SK21/YieldFlo/PCBs/Moisture1/Moisture1.png

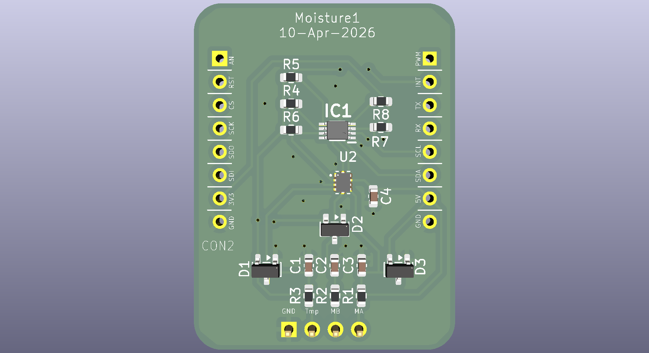
PCBs/Moisture1/Moisture1.png
