SK21/YieldFlo/PCBs/YF1/YF1.png

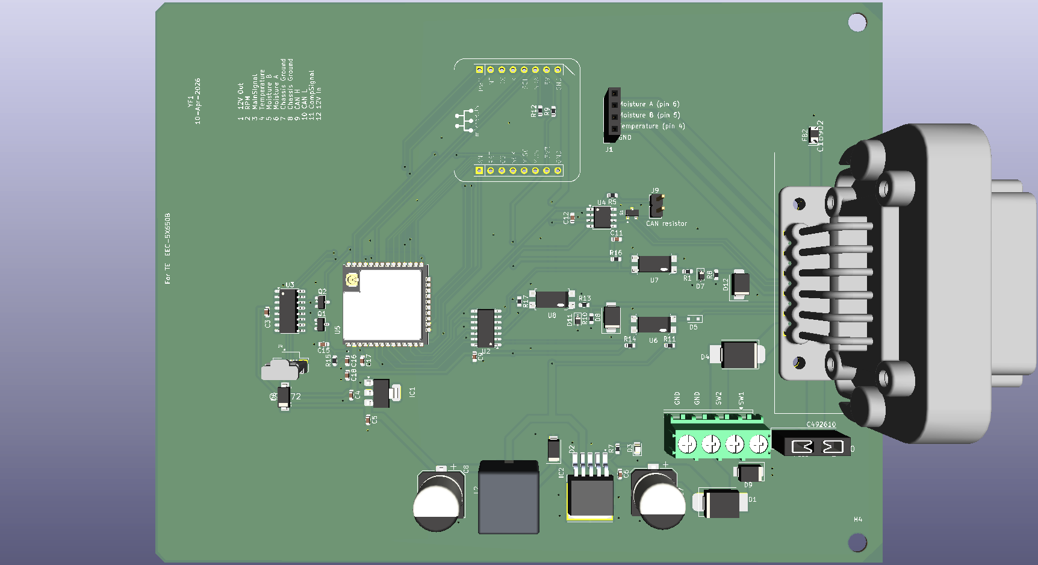
PCBs/YF1/YF1.png
