SK21/YieldFlo/PCBs/Moisture1/jlcpcb/production_files/BOM-Moisture1.csv

Comment | Designator | Footprint | LCSC | Quantity
0.1uF | C4 | C_0603_1608Metric | C14663 | 1
10nf | C1,C2,C3 | C_0603_1608Metric | C389113 | 3
1K | R1,R2,R3 | R_0603_1608Metric | C21190 | 3
200K | R6 | R_0603_1608Metric | C25811 | 1
217 | R7,R8 | R_0603_1608Metric | C2930075 | 2
341 | R4,R5 | R_0603_1608Metric | C23138 | 2
ADS1115IRUGR | U2 | IC_ADS1115IRUGR | C2651328 | 1
BAV99 | D1,D2,D3 | SOT-23 | C2500 | 3
PCA9306DCUR | IC1 | PCA9306DCUR | C33196 | 1
MIKROBUS_MODULE_CONN | CON2 | MIKROBUS_MODULE_CONN |  | 1
Conn_01x04_Pin | J1 | PinHeader_1x04_P2.54mm_Vertical |  | 1
