SK21/YieldFlo/InnoMaker_Setup.txt

YieldFlo — InnoMaker USB2CAN setup
==================================

The next YieldFlo build adds support for the InnoMaker USB2CAN adapter.
To use it:

1. Install InnoMaker's Windows driver for the USB2CAN adapter
   (from the InnoMaker website or their driver installer).

2. Download the InnoMaker USB2CAN C# SDK and copy these two files
   into the YieldFlo application folder (the folder containing
   YieldFlo.exe):

       InnoMakerUsb2CanLib.dll
       LibUsbDotNet.dll

   These are the only DLLs in the C# SDK's Lib folder — InnoMaker
   ships them 32-bit only. Download them as raw files (from the GitHub
   page use the Download button on each file, or download the whole
   repo as a zip — saving the web page itself gives a corrupt DLL).

   If the error log said "bitness does not match" or "class
   InnoMakerUsb2CanLib not found", update YieldFlo.exe to the newest
   build (2026-07-06 or later) — the DLLs are fine, keep them where
   they are.

PCAN (alternative adapter)
--------------------------
   YieldFlo builds BEFORE 2026-07-06 did not support PCAN at all (the
   driver was an empty stub) — update YieldFlo.exe first. Then: install
   the PEAK device driver package from peak-system.com (it includes
   PCAN-Basic), select CAN Driver: PCAN in YieldFlo, Save & Apply,
   restart. Nothing needs to be copied into the app folder.

Checking whether the module is sending (any adapter)
----------------------------------------------------
   The module sends unsolicited; the PC only listens. But CAN frames
   need at least one ACTIVE receiver on the bus — if no program has the
   adapter open, the module's frames are not acknowledged and (on the
   STM32 module, which sends single-shot) simply vanish. "No messages
   on the bus" therefore usually means the PC side never opened, not
   that the module is silent.

   To test the module independent of YieldFlo: open PCAN-View (PEAK's
   free tool) at 250 kbit/s in normal mode (NOT listen-only). A working
   module shows ID 18FF00F8h at 5 Hz and 18FF01F8h at 1 Hz.

3. In YieldFlo:  Menu > Settings > Module communication
   - select CAN
   - CAN Driver: InnoMaker
   - COM Port is ignored for InnoMaker (the first adapter found is
     used), then Save & Apply and restart when prompted.

If CAN still fails to start, send the newest file from:

       Documents\YieldFlo\Logs

The exact reason (DLL missing, wrong bitness, no adapter found, etc.)
is written there.

STM32F1 module checklist (module side)
--------------------------------------
- The sketch must be compiled with USB support set to "None"
  (Arduino IDE > Tools > USB support). USB and CAN share memory on
  the F103 — with USB enabled, CAN silently does not work.
- Debug output is on USART1 (PA9/PA10) at 38400 baud; at power-up it
  should print "CAN started at 250kbps."
- CAN wiring: PB9 = TX, PB8 = RX to the transceiver; bus needs 120 ohm
  termination at both ends.
