SK21/YieldFlo/YieldFlo/Help/YieldFlo User Manual.html

# YieldFlo User Manual

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

## Table of Contents

1. Getting Started
2. Main Screen
3. Jobs
4. Crops
5. Headers
6. Profiles
7. Fields
8. Yield Calibration
9. Moisture Calibration
10. Yield Map
11. Job Report
12. Settings
13. Language
14. Module Web Portal
15. Troubleshooting

↑ Contents

## 1. Getting Started

### Requirements

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

No installer is required. Extract the YieldFlo folder to any location and run YieldFlo.exe.

### Hardware module

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

### Network

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

### Recommended first-run setup

On first launch YieldFlo creates a default crop, header, and profile. Before starting your first job:

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

↑ Contents

## 2. Main Screen

The main screen displays live harvest data and job status.

### Toolbar buttons

Left to right, as they appear on screen:

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

### Data panels

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

### Sensor bars

Two horizontal bar gauges below the data panels:

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

### Status bar

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

### Compact (mini) view

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

↑ Contents

## 3. Jobs

Menu: Menu → Jobs

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

### Starting a job

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

### Managing jobs

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

Only one job can be active at a time.

### Auto-pause

The job automatically pauses when harvesting stops:

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

### Manual pause and resume

Press Pause on the main screen to manually pause recording. Press Start to resume.

### Stopping a job

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

### Resume on start

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

↑ Contents

## 4. Crops

Menu: Menu → Crops

Crops store the grain-specific parameters used in yield calculations and reporting.

### Crop settings

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

### Adding a crop

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

↑ Contents

## 5. Headers

Menu: Menu → Headers

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

### Header settings

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

### Adding a header

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

↑ Contents

## 6. Profiles

Menu: Menu → Profiles

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

### Profile settings

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

### Adding a profile

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

At least one profile must exist at all times.

↑ Contents

## 7. Fields

Menu: Menu → Fields

Fields are optional location labels that can be assigned to jobs for organisation and reporting.

### Adding a field

1. Press New and enter a field name
2. Press Save

Fields are not required. A job can be created without a field selected.

### Importing fields from AgOpenGPS

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

↑ Contents

## 8. Yield Calibration

Menu: Menu → Yield Cal

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

### Setting the baseline

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

### Noise readout

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

### Paddle rate readout

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

### Processing delay

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

### Running a calibration pass

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

### Manual factor adjustment

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

↑ Contents

## 9. Moisture Calibration

Menu: Menu → Moisture Cal

Moisture and temperature readings are both calculated the same way:

Value = raw_count × scale  +  offset

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

scale = known_value / raw_count

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

### Moisture calibration procedure

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

### Moisture calibration fields

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

### Temperature calibration

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

Note: Temperature calibration is optional. Temperature does not appear directly on the main screen.

↑ Contents

## 10. Yield Map

Menu: Menu → Yield Map

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

### Colour scale

Yield is mapped to a five-colour gradient:

Colour | Yield
Blue | Lowest
Cyan | Low
Green | Mid
Yellow | High
Red | Highest

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

### Mini mode

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

The mini map position is remembered between sessions.

### Full-screen mode

Click the map or press × to expand to full screen. The toolbar at the top provides:

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

The map can be dragged in both mini and full-screen modes.

### Live update during harvest

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

### Recalculating yield

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

### Exporting the map as a PNG

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

The export folder is remembered for subsequent exports.

↑ Contents

## 11. Job Report

Menu: Menu → Reports

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

### Report contents

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

### Printing a report

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

### CSV export

Press Export CSV to save all raw data points for the selected job.

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

↑ Contents

## 12. Settings

Menu: Menu → Settings

### Units

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

### Module communication

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

#### Supported CAN adapters

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

### Resume Job on Start

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

### Saving settings

Press Save & Apply to save and apply all settings immediately.

↑ Contents

## 13. Language

Menu: Menu → Language

YieldFlo supports the following languages:

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

### Changing language

1. Press Menu → Language
2. Select the desired language from the list
3. Press Save & Restart

YieldFlo will restart automatically with the new language applied.

Note: If AgOpenGPS is already installed, YieldFlo will automatically use the same language on first launch.

↑ Contents

## 14. Module Web Portal

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

### Opening the portal

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

### Settings

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

Press Save / Restart to store the settings in the module and restart it.

### Firmware update

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

↑ Contents

## 15. Troubleshooting

### GPS indicator stays red

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

### Module indicator stays off

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

### Yield reads zero or very low

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

### Moisture reads incorrectly

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

### App crashes on start

- Check YieldFlo_Crash.log in the application folder for details

### Job does not resume after restart

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

### AOG UDP failed to start

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

↑ Contents

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
