SK21/YieldFlo/PCBs/Moisture1/Moisture1.pdf

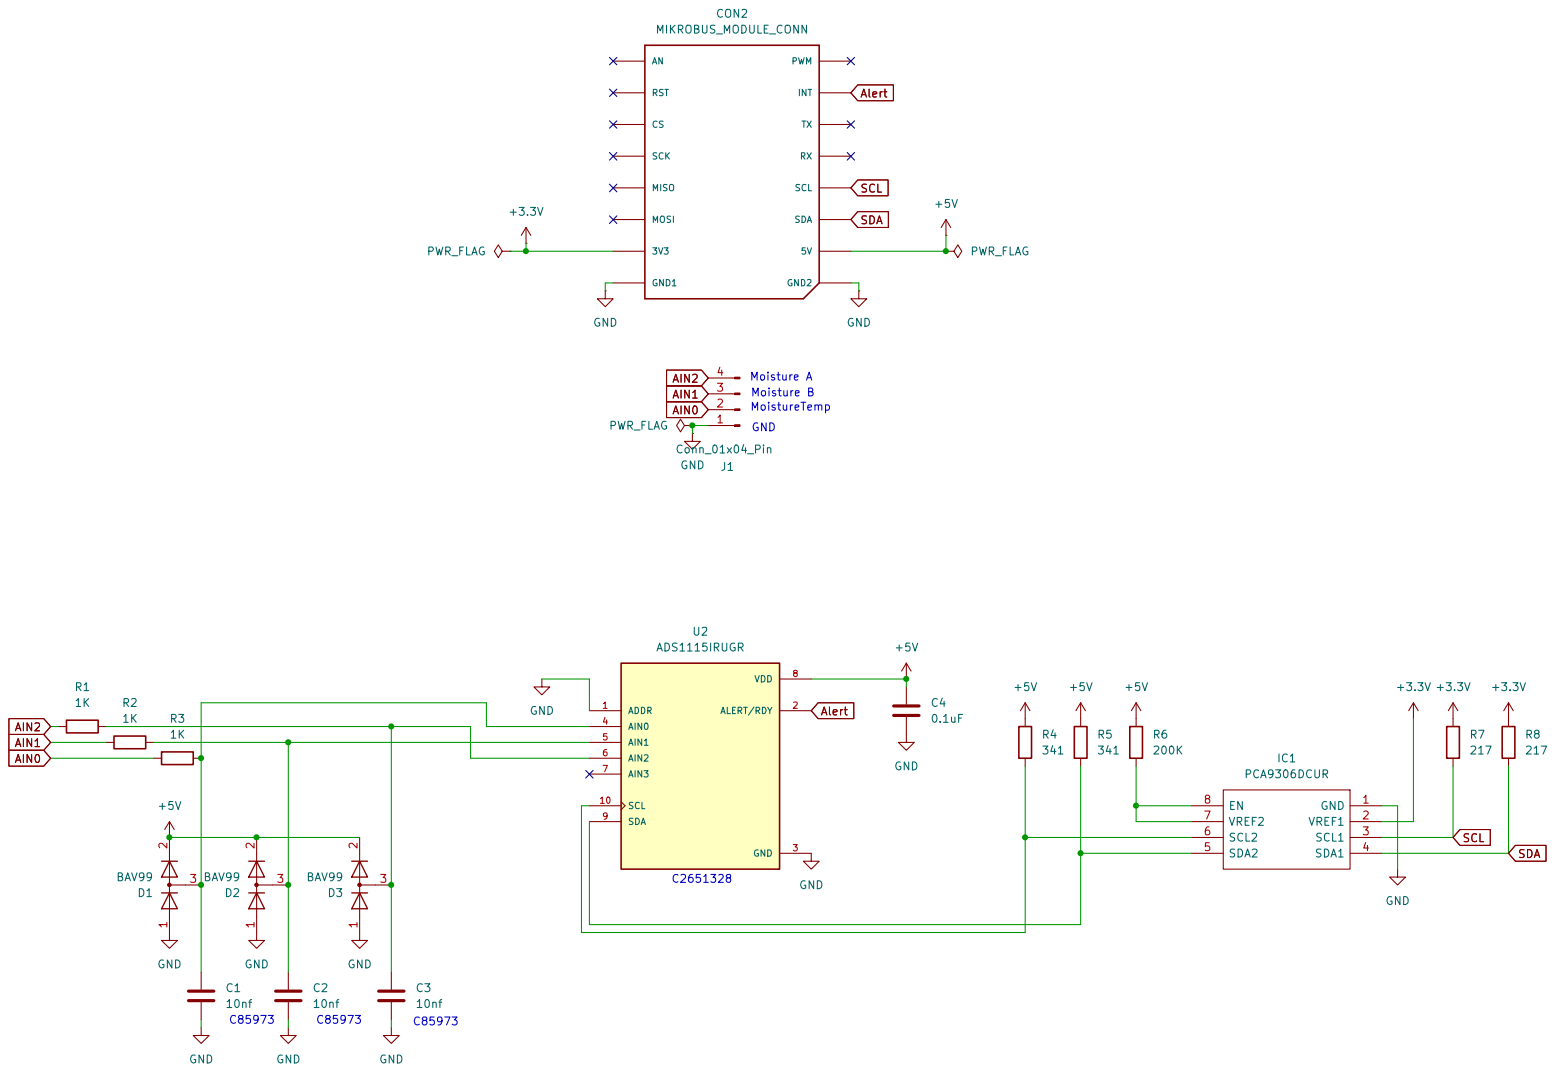
[picture p4: page 1]
