SK21/YieldFlo/PCBs/YF1/YF1.pdf

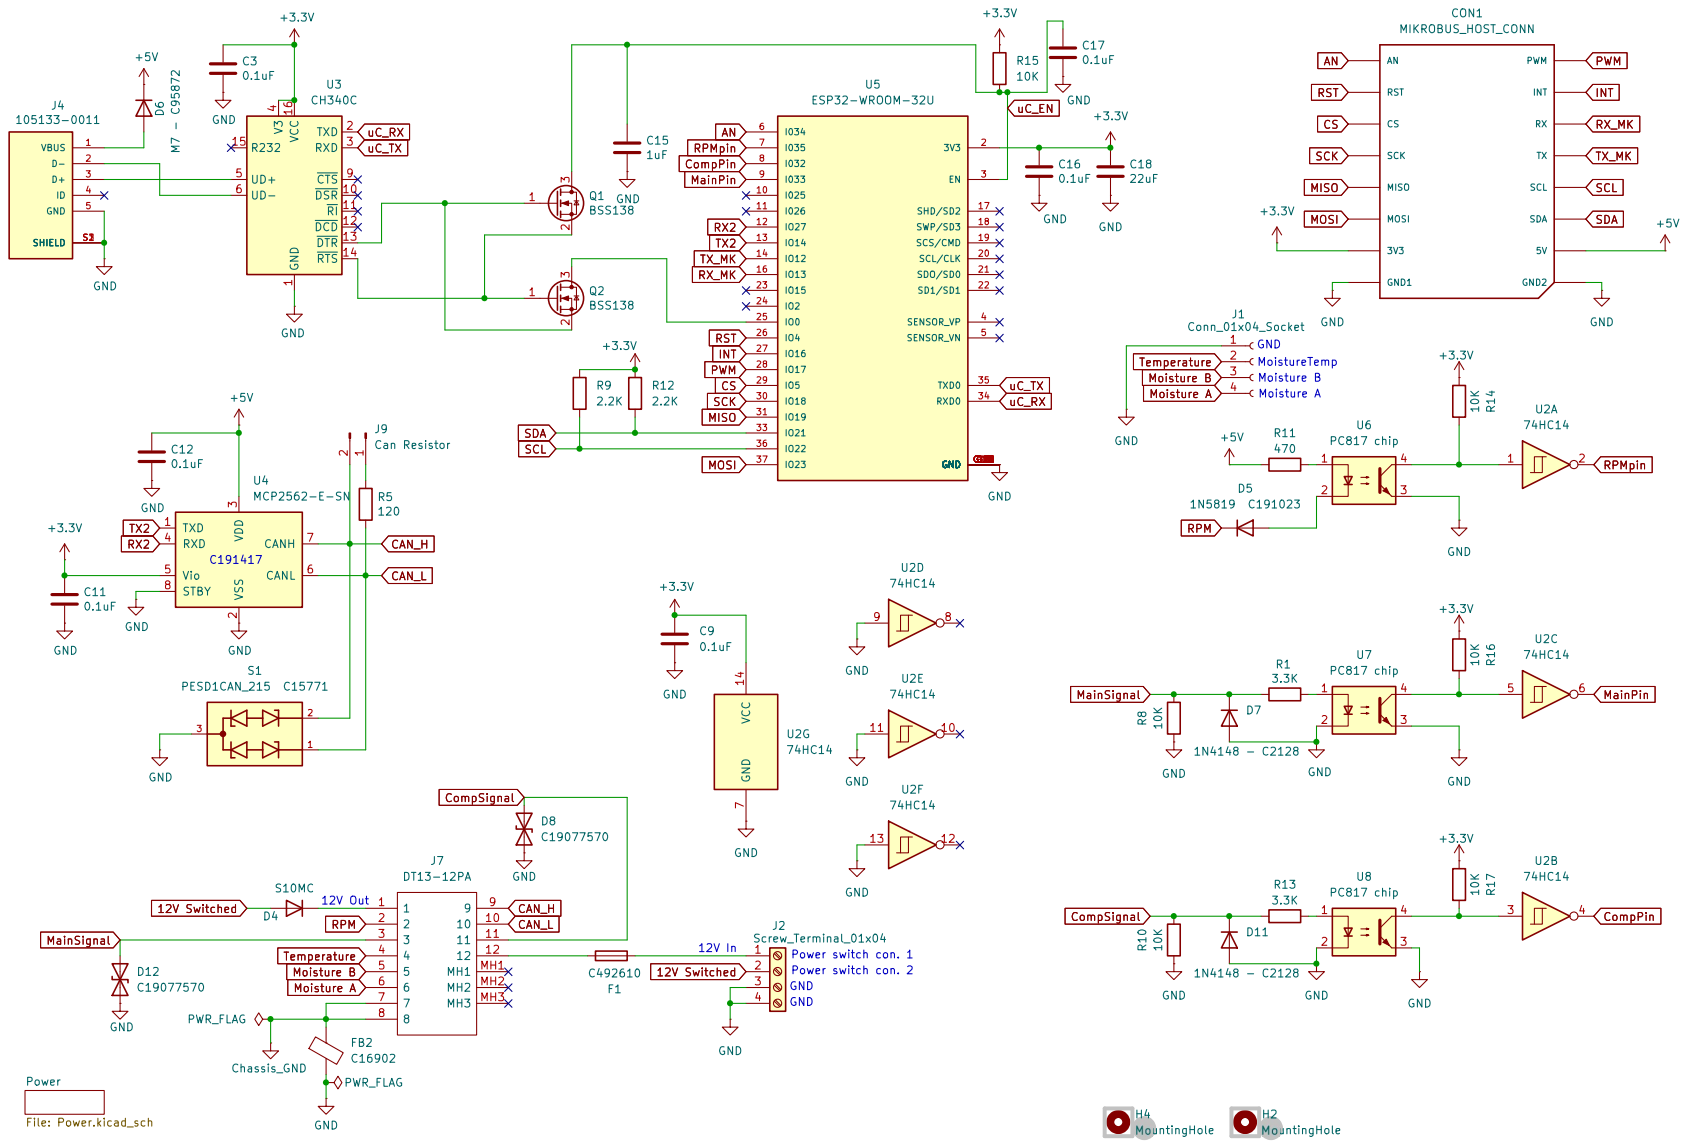
[picture p5: page 1]

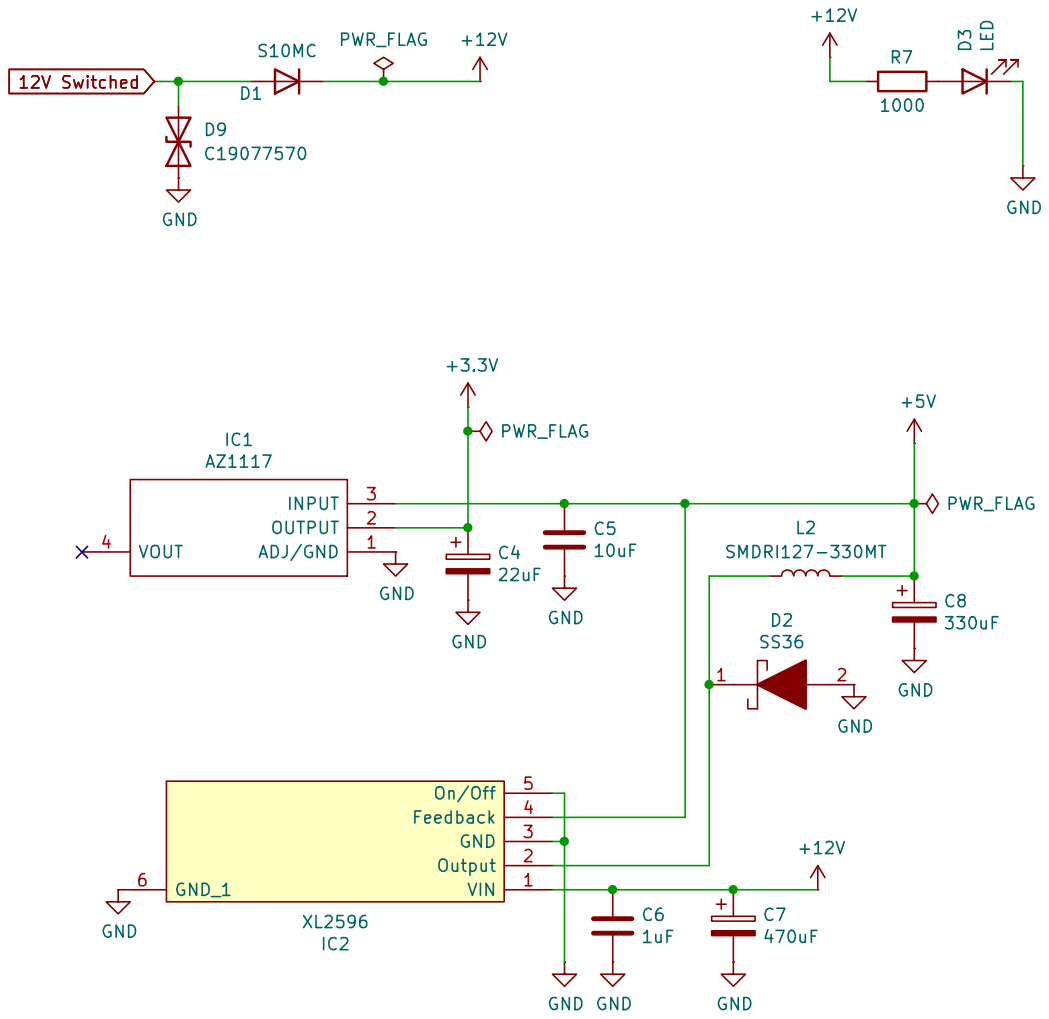
[picture p6: page 2]
