SK21/YieldFlo/PCBs/YF1/YF1.kicad_pcb

## KiCad design PCBs/YF1/YF1.kicad_pcb (2026-07-23)

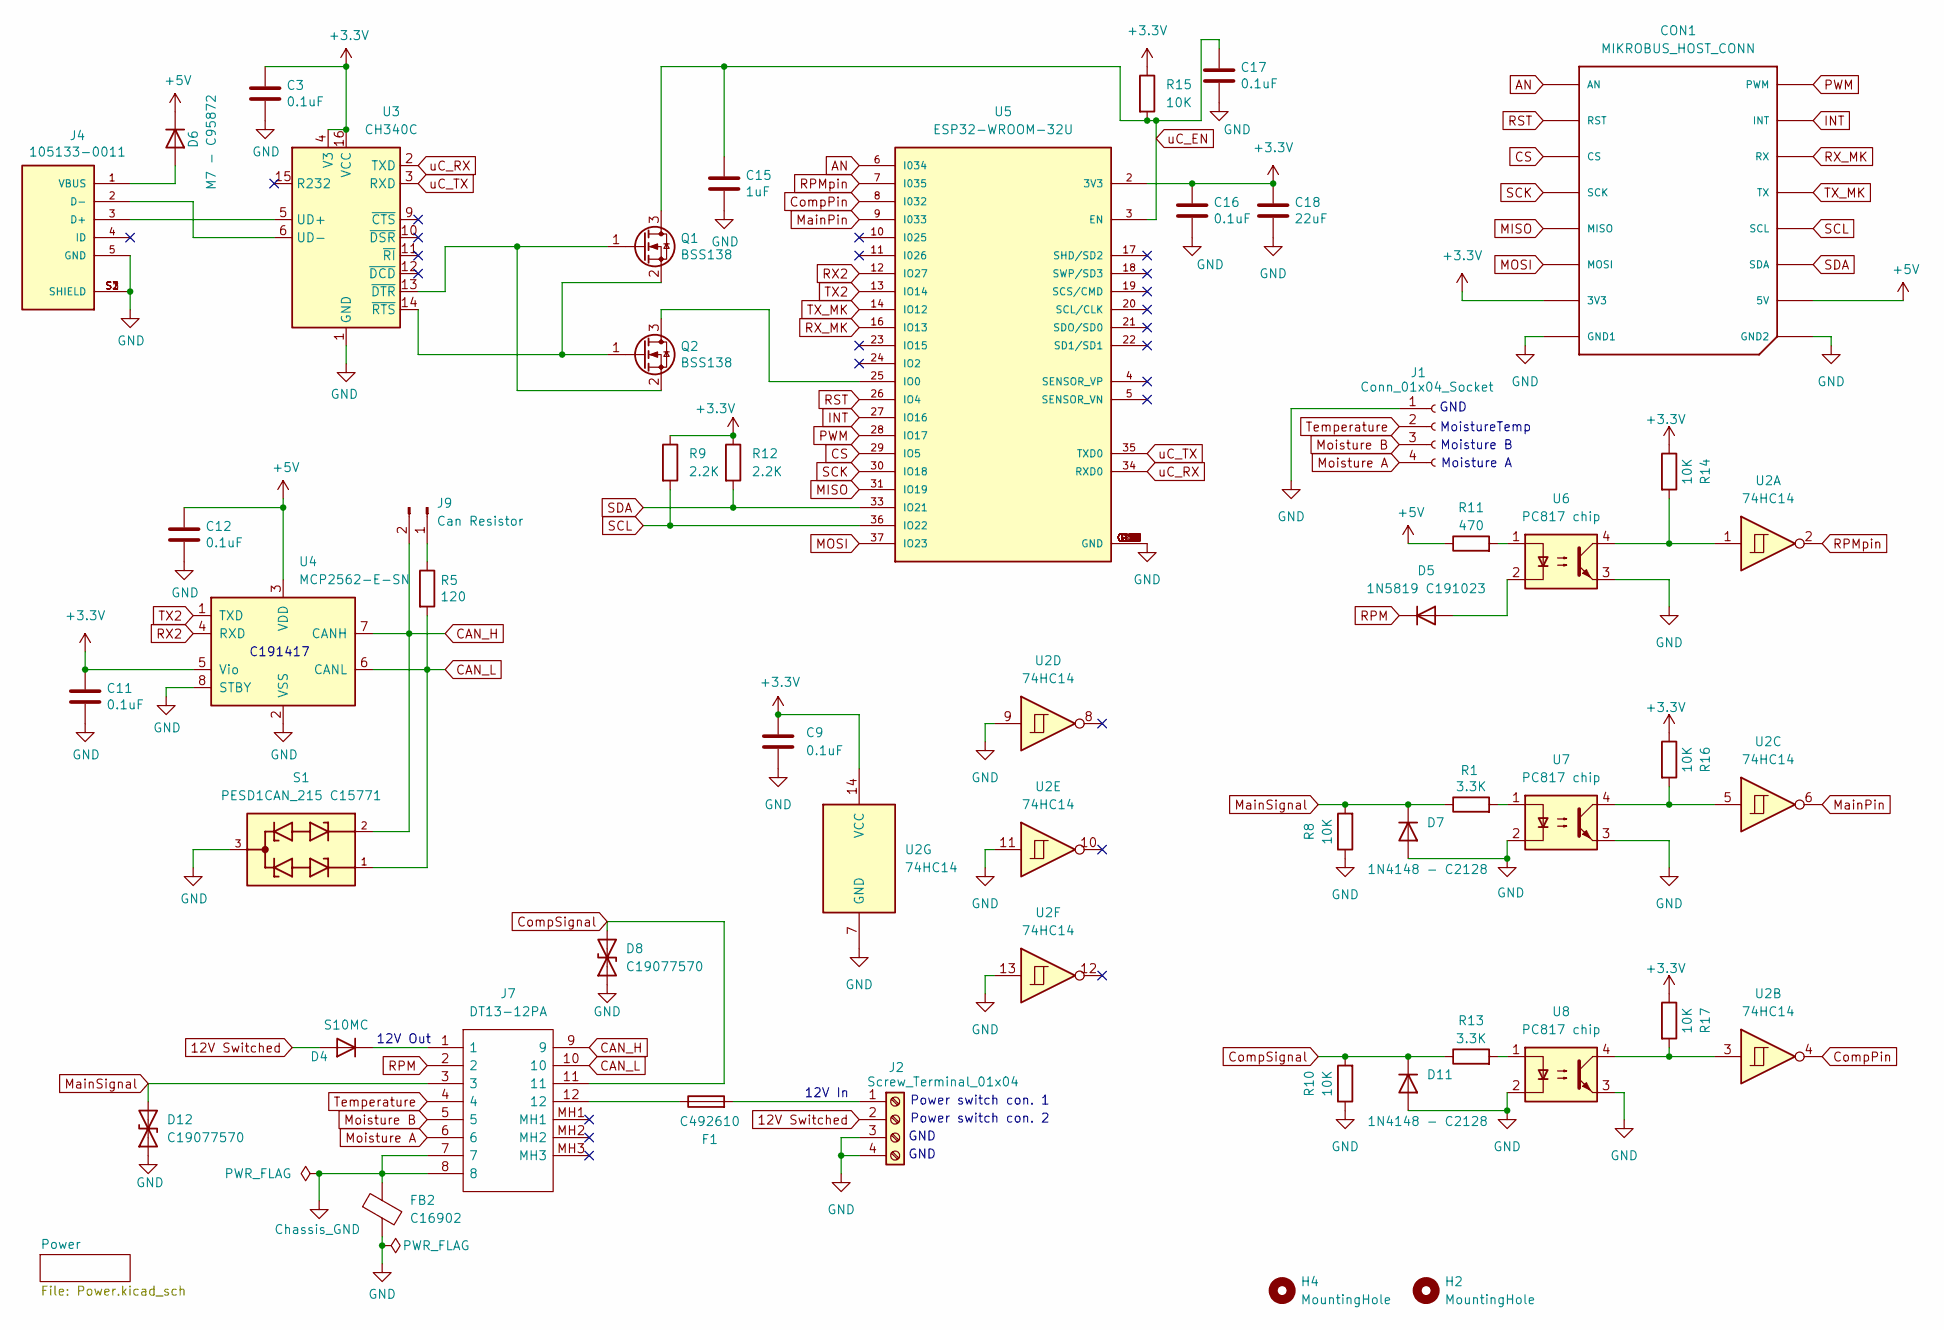
[picture p7: schematic YF1.kicad_sch]

Parts:
C3, C9, C11, C12, C16, C17: 0.1uF; C_0603_1608Metric
C15: 1uF; C_0603_1608Metric
C18: 22uF; C_0603_1608Metric
CON1: MIKROBUS_HOST_CONN
D4: S10MC; D_SMC_larger_pads
D5: 1N5819 C191023; 1N5819
D6: M7 - C95872; DO-214AC
D7, D11: 1N4148 - C2128; D_SOD-323
D8, D12: C19077570; D_SMB
F1: C492610; Fuse_Holder_C492610
FB2: C16902; D_1206_3216Metric
H2, H4: MountingHole; MountingHole_4.3mm_M4
J1: Conn_01x04_Socket; PinSocket_1x04_P2.54mm_Vertical
J2: Screw_Terminal_01x04; TerminalBlock_Phoenix_PT-1,5-4-5.0-H_1x04_P5.00mm_Horizontal
J4: 105133-0011; MOLEX_105133-0011; PARTREV C
J7: DT13-12PA; DT1312PA; Manufacturer_Part_Number DT13-12PA; Mouser Part Number 571-DT13-12PA
J9: Can Resistor; PinHeader_1x02_P2.54mm_Vertical
Q1, Q2: BSS138; SOT-23
R1, R13: 3.3K; R_0603_1608Metric
R5: 120; R_0603_1608Metric
R8, R10, R14, R15, R16, R17: 10K; R_0603_1608Metric
R9, R12: 2.2K; R_0603_1608Metric
R11: 470; R_0603_1608Metric
S1: PESD1CAN_215 C15771; DIO_PESD1CAN_215
U2: 74HC14; SOIC-14_3.9x8.7mm_P1.27mm
U3: CH340C; SOIC-16_3.9x9.9mm_P1.27mm
U4: MCP2562-E-SN; SOIC-8_3.9x4.9mm_P1.27mm
U5: ESP32-WROOM-32U; XCVR_ESP32-WROOM-32U; PARTREV V1.9
U6, U7, U8: PC817 chip; SMD-4_4.6x7.62mm_P2.54mm

Connections:
12V Switched: D4.2 (A), J2.2; also elsewhere on the board
+3.3V: C3.1, C9.1, C11.1, C16.1, C18.1, CON1.P7 (3V3), R9.1, R12.1, R14.1, R15.1, R16.1, R17.1, U2.14 (VCC), U3.4 (V3), U3.16 (VCC), U4.5 (Vio), U5.2 (3V3); also elsewhere on the board
+5V: C12.1, CON1.P10 (5V), D6.1 (K), R11.1, U4.3 (VDD); also elsewhere on the board
AN: CON1.P1 (AN), U5.6 (I034)
CAN_H: J7.9, J9.2, S1.2, U4.7 (CANH)
CAN_L: J7.10, R5.2, S1.1, U4.6 (CANL)
CS: CON1.P3 (CS), U5.29 (IO5)
Chassis_GND: FB2.1, J7.7, J7.8
CompPin: U2.4, U5.8 (I032)
CompSignal: D8.2 (A2), D11.1 (K), J7.11, R10.2, R13.1
GND: C3.2, C9.2, C11.2, C12.2, C15.2, C16.2, C17.2, C18.2, CON1.P8 (GND1), CON1.P9 (GND2), D7.2 (A), D8.1 (A1), D11.2 (A), D12.1 (A1), FB2.2, J1.1, J2.3, J2.4, J4.5 (GND), J4.S1 (SHIELD), J4.S2 (SHIELD), J4.S3 (SHIELD), R8.1, R10.1, S1.3, U2.7 (GND), U2.9, U2.11, U2.13, U3.1 (GND), U4.2 (VSS), U4.8 (STBY), U5.1 (GND), U5.15 (GND), U5.38 (GND), U5.G.1 (GND), U5.G.2 (GND), U5.G.4 (GND), U5.G.5 (GND), U5.G.6 (GND), U5.G.7 (GND), U5.G.8 (GND), U5.G.9 (GND), U5.G.10 (GND), U5.G.11 (GND), U5.G.12 (GND), U5.G.13 (GND), U5.G.14 (GND), U5.G.15 (GND), U5.G.16 (GND), U5.G.17 (GND), U5.G.18 (GND), U5.G.19 (GND), U5.G.20 (GND), U5.G.21 (GND), U5.G.22 (GND), U6.3, U7.2, U7.3, U8.2, U8.3; also elsewhere on the board
INT: CON1.P15 (INT), U5.27 (IO16)
MISO: CON1.P5 (MISO), U5.31 (IO19)
MOSI: CON1.P6 (MOSI), U5.37 (IO23)
MainPin: U2.6, U5.9 (I033)
MainSignal: D7.1 (K), D12.2 (A2), J7.3, R1.1, R8.2
Moisture A: J1.4, J7.6
Moisture B: J1.3, J7.5
unnamed: D4.1 (K), J7.1
unnamed: D5.2 (A), U6.2
unnamed: D6.2 (A), J4.1 (VBUS)
unnamed: F1.1, J7.12
unnamed: F1.2, J2.1
unnamed: J4.3 (D+), U3.5 (UD+)
unnamed: J4.2 (D-), U3.6 (UD-)
unnamed: J9.1, R5.1
unnamed: Q1.1 (G), Q2.2 (S), U3.13 (~DTR)
unnamed: Q1.2 (S), Q2.1 (G), U3.14 (~RTS)
unnamed: Q2.3 (D), U5.25 (IO0)
unnamed: R1.2, U7.1
unnamed: R11.2, U6.1
unnamed: R13.2, U8.1
unnamed: R14.2, U2.1, U6.4
unnamed: R16.2, U2.5, U7.4
unnamed: R17.2, U2.3, U8.4
PWM: CON1.P16 (PWM), U5.28 (IO17)
RPM: D5.1 (K), J7.2
RPMpin: U2.2, U5.7 (I035)
RST: CON1.P2 (RST), U5.26 (IO4)
RX2: U4.4 (RXD), U5.12 (IO27)
RX_MK: CON1.P14 (RX), U5.16 (IO13)
SCK: CON1.P4 (SCK), U5.30 (IO18)
SCL: CON1.P12 (SCL), R9.2, U5.36 (IO22)
SDA: CON1.P11 (SDA), R12.2, U5.33 (IO21)
TX2: U4.1 (TXD), U5.13 (IO14)
TX_MK: CON1.P13 (TX), U5.14 (IO12)
Temperature: J1.2, J7.4
uC_EN: C15.1, C17.1, Q1.3 (D), R15.2, U5.3 (EN)
uC_RX: U3.2 (TXD), U5.34 (RXD0)
uC_TX: U3.3 (RXD), U5.35 (TXD0)

Notes on the sheet:
Moisture A
12V Out
GND
MoistureTemp
12V In
Power switch con. 1
Power switch con. 2
C191417
Moisture B

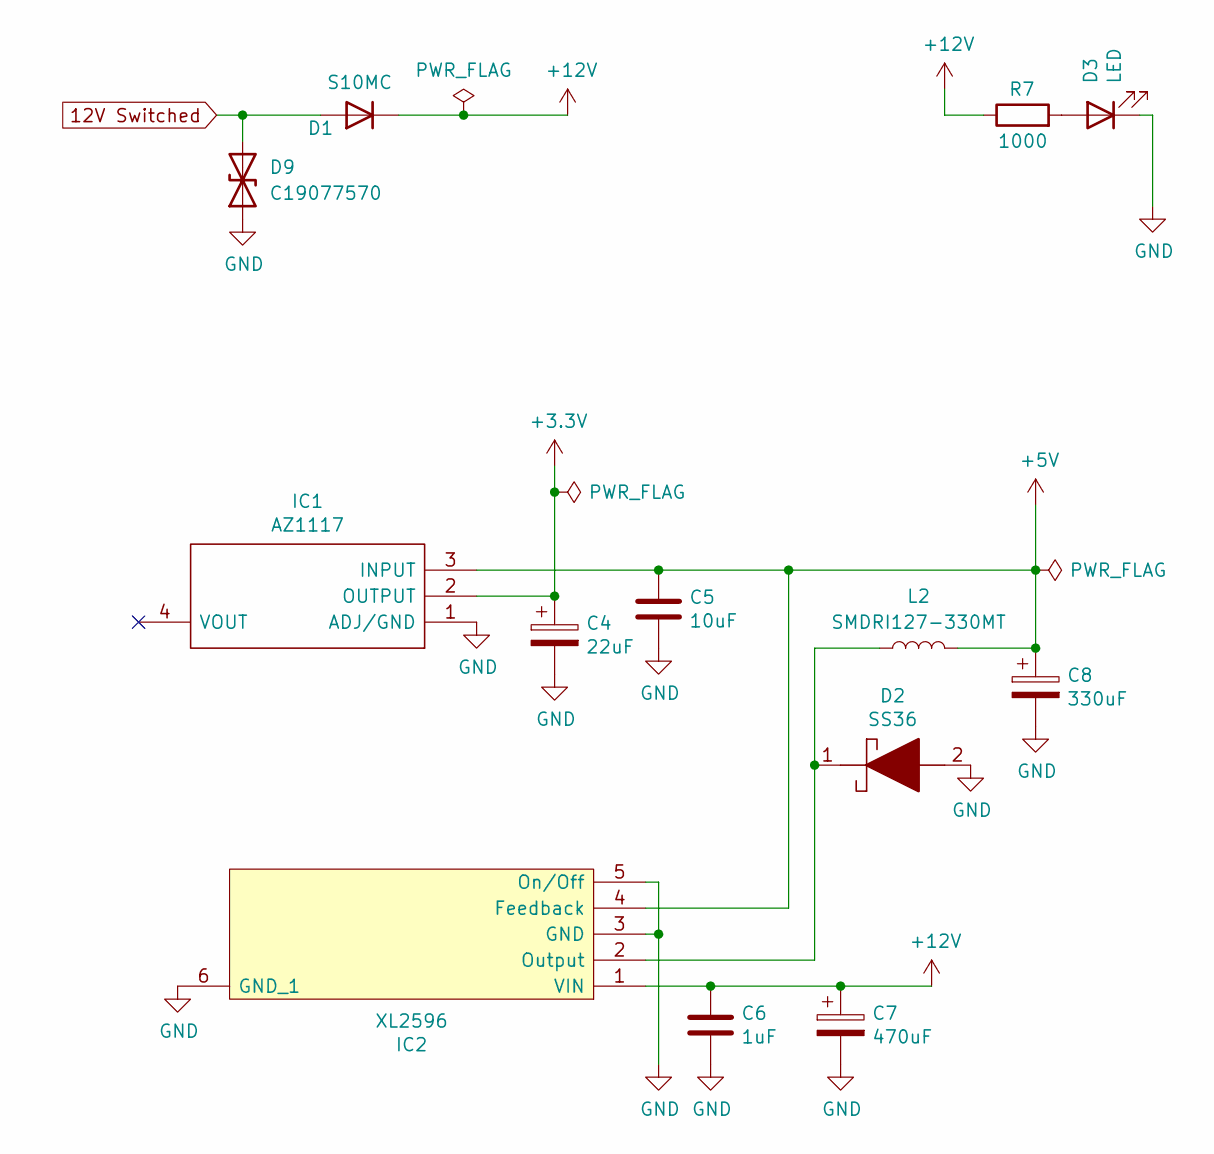
[picture p8: schematic Power.kicad_sch]

Parts:
C4: 22uF; C_0603_1608Metric
C5: 10uF; C_0603_1608Metric
C6: 1uF; C_0603_1608Metric
C7: 470uF; CP_Elec_10x10.5
C8: 330uF; CP_Elec_10x10.5
D1: S10MC; D_SMC_larger_pads
D2: SS36; SMA(DO-214AC)
D3: LED; LED_0805_2012Metric
D9: C19077570; D_SMB
IC1: AZ1117; SOT-223
IC2: XL2596; TO263-5L
L2: SMDRI127-330MT; TMPA1265SP-101MN-D
R7: 1000; R_0603_1608Metric

Connections:
12V Switched: D1.2 (A), D9.2 (A2); also elsewhere on the board
+3.3V: C4.1, IC1.2 (OUTPUT); also elsewhere on the board
+5V: C5.1, C8.1, IC1.3 (INPUT), IC2.4 (Feedback), L2.2; also elsewhere on the board
+12V: C6.1, C7.1, D1.1 (K), IC2.1 (VIN), R7.1
GND: C4.2, C5.2, C6.2, C7.2, C8.2, D2.2, D3.1 (K), D9.1 (A1), IC1.1 (ADJ/GND), IC2.3 (GND), IC2.5 (On/Off), IC2.6 (GND_1); also elsewhere on the board
unnamed: D3.2 (A), R7.2
unnamed: D2.1, IC2.2 (Output), L2.1

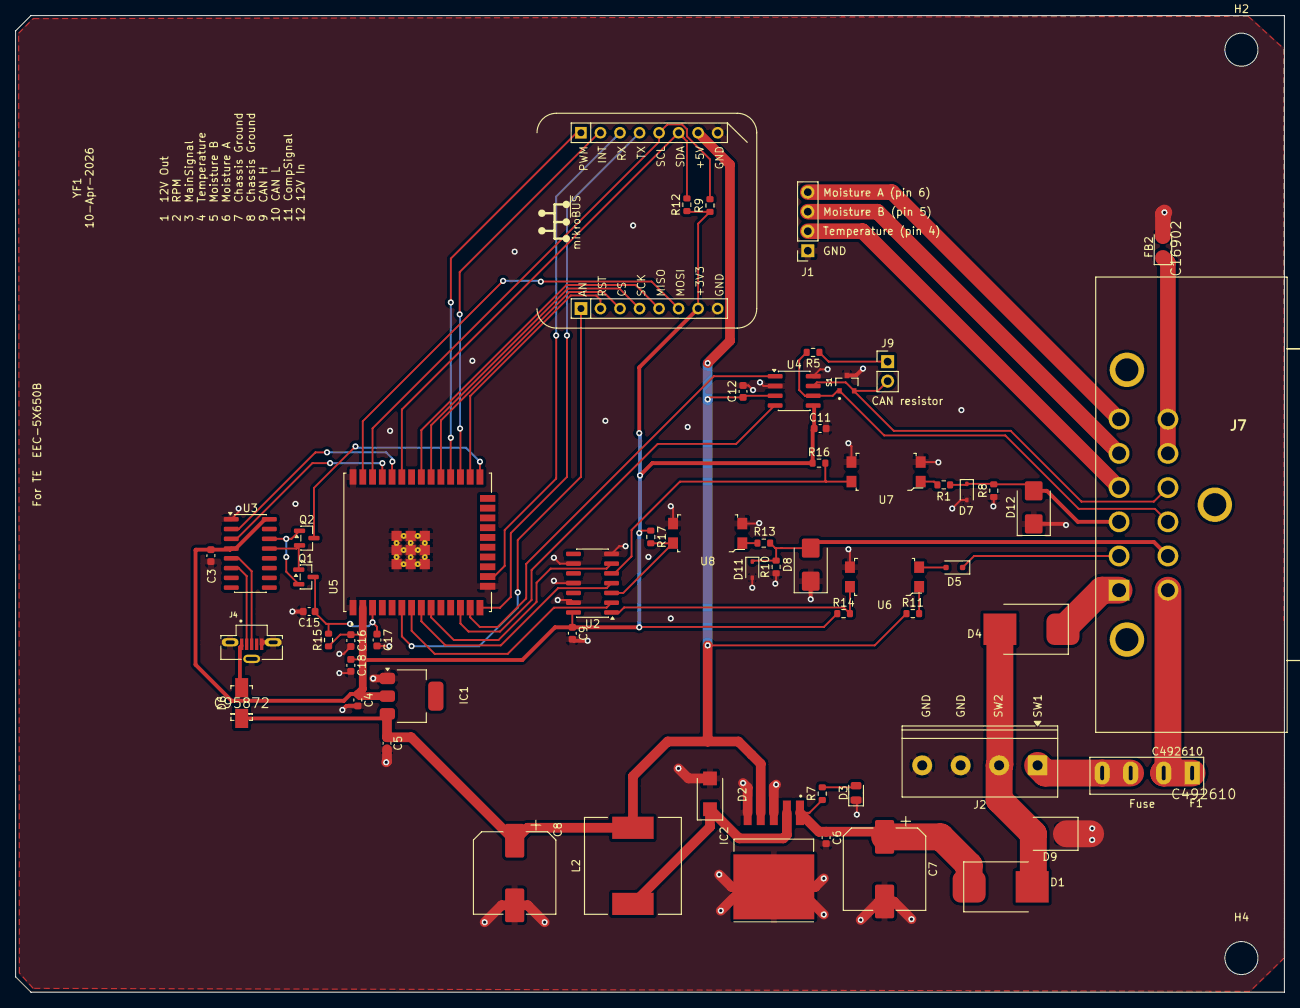
[picture p9: board YF1.kicad_pcb from above]

Board: 2 copper layers, 165.0 x 127.0 mm, 60 parts (0 on the bottom side), 53 nets.
