SK21/YieldFlo/PCBs/Moisture1/Moisture1.kicad_pcb

## KiCad design PCBs/Moisture1/Moisture1.kicad_pcb (2026-07-23)

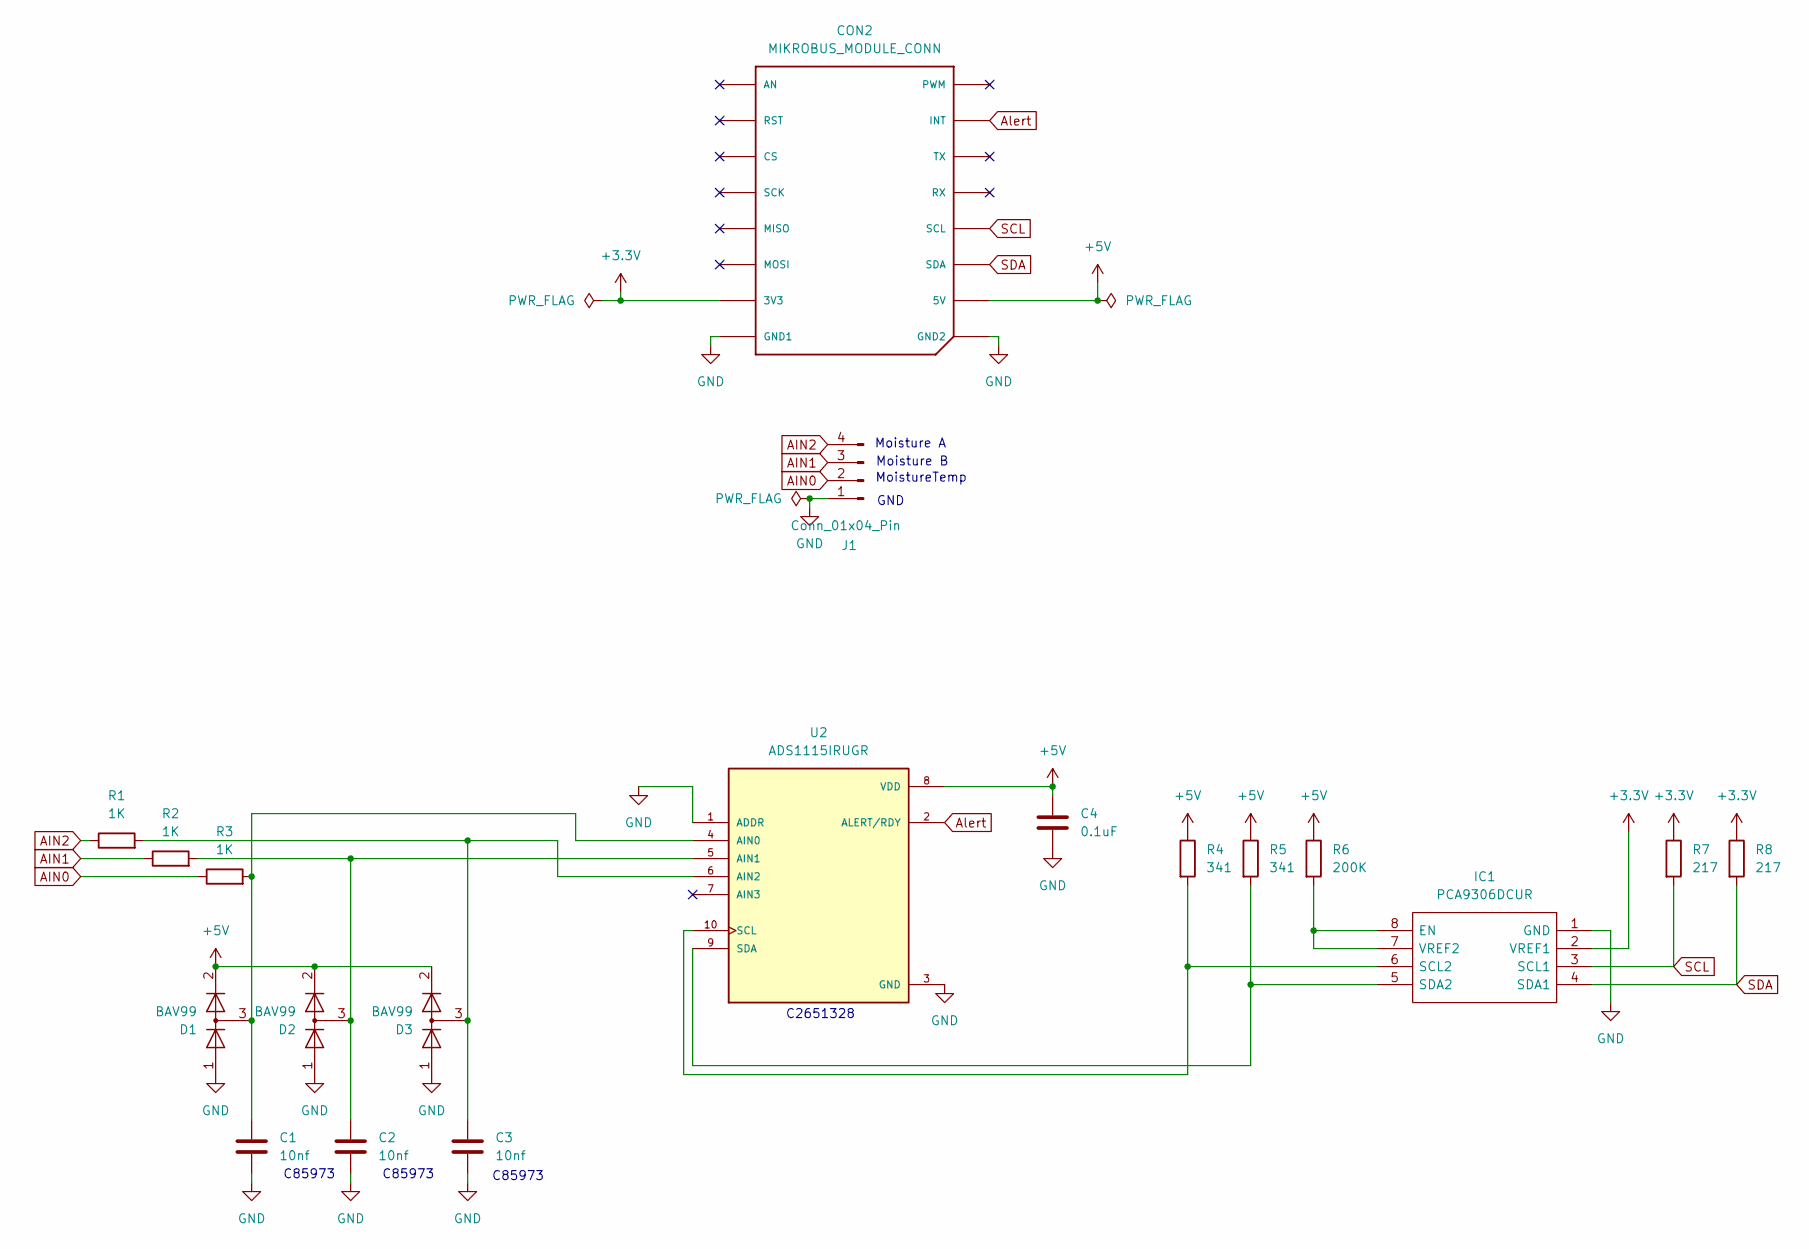
[picture p10: schematic Moisture1.kicad_sch]

Parts:
C1, C2, C3: 10nf; C_0603_1608Metric
C4: 0.1uF; C_0603_1608Metric
CON2: MIKROBUS_MODULE_CONN
D1, D2, D3: BAV99; SOT-23
IC1: PCA9306DCUR; Mouser Part Number 595-PCA9306DCUR
J1: Conn_01x04_Pin; PinHeader_1x04_P2.54mm_Vertical
R1, R2, R3: 1K; R_0603_1608Metric
R4, R5: 341; R_0603_1608Metric
R6: 200K; R_0603_1608Metric
R7, R8: 217; R_0603_1608Metric
U2: ADS1115IRUGR; IC_ADS1115IRUGR

Connections:
+3.3V: CON2.P7 (3V3), IC1.2 (VREF1), R7.1, R8.1
+5V: C4.1, CON2.P10 (5V), D1.2 (A), D2.2 (A), D3.2 (A), R4.1, R5.1, R6.1, U2.8 (VDD)
AIN0: J1.2, R3.1
AIN1: J1.3, R2.1
AIN2: J1.4, R1.1
Alert: CON2.P15 (INT), U2.2 (ALERT/RDY)
GND: C1.2, C2.2, C3.2, C4.2, CON2.P8 (GND1), CON2.P9 (GND2), D1.1 (K), D2.1 (K), D3.1 (K), IC1.1 (GND), J1.1, U2.1 (ADDR), U2.3 (GND)
unnamed: IC1.7 (VREF2), IC1.8 (EN), R6.2
unnamed: IC1.6 (SCL2), R4.2, U2.10 (SCL)
unnamed: IC1.5 (SDA2), R5.2, U2.9 (SDA)
unnamed: C1.1, D1.3 (K), R3.2, U2.4 (AIN0)
unnamed: C2.1, D2.3 (K), R2.2, U2.5 (AIN1)
unnamed: C3.1, D3.3 (K), R1.2, U2.6 (AIN2)
SCL: CON2.P12 (SCL), IC1.3 (SCL1), R7.2
SDA: CON2.P11 (SDA), IC1.4 (SDA1), R8.2

Notes on the sheet:
C85973
GND
C2651328
MoistureTemp
Moisture B
Moisture A

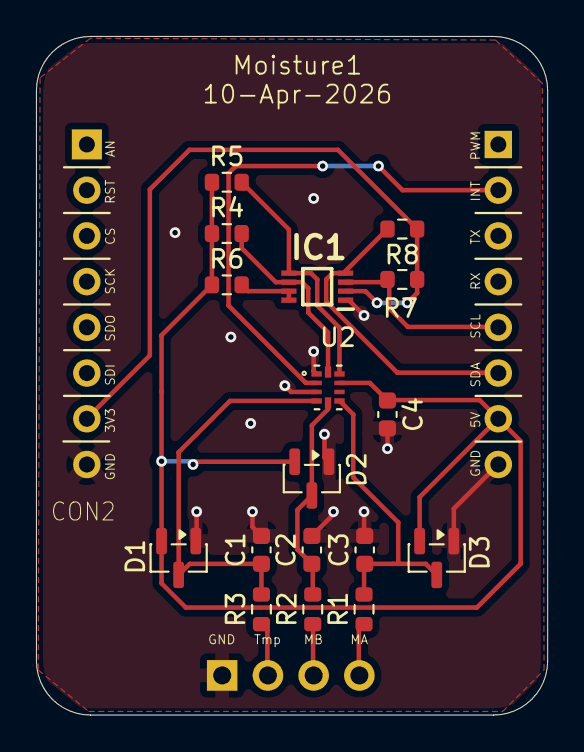
[picture p11: board Moisture1.kicad_pcb from above]

Board: 2 copper layers, 28.4 x 37.7 mm, 19 parts (1 on the bottom side), 15 nets.
