SK21/YieldFlo/(commit log)

2026-03-18 fix calibrate
2026-03-29 fix missing mini button on main form
2026-03-29 esp32 web page
2026-07-05 account for flow delay
2026-07-05 STM32F1 module port - CAN bus only
    Port of the ESP32 module firmware for STM32F103 (Blue Pill) on the
    official STM32duino core with the STM32_CAN library. Same CAN frames
    (0x18FF00F8 / 0x18FF01F8, 250 kbps) so the PC app works unchanged.
    WiFi/portal/OTA removed; settings are compile-time constants.
    Bus Off recovery via bxCAN ABOM, single-shot TX. Compile-verified
    for Generic F103C8 (44% flash, 7% RAM).
2026-07-05 ESP32 module: README, build fixes for plain Arduino IDE
    Add README (portal, pins, UDP/CAN protocol, build). Make the sketch
    build outside Visual Micro: drop unused Adafruit BusIO includes, add
    IRAM_ATTR ISR prototypes the sketch preprocessor won't generate, and
    move ESP2SOTA_RC into src/ so Arduino builds compile it (vcxproj lists
    the files explicitly for Visual Micro). Verified in both build systems.
    InoID bumped to 5076.
    [YieldFlo_ESP32.ino]
2026-07-05 Update ESP32 prebuilt firmware image (InoID 5076)
2026-07-06 fix tx error counter
    [partitions.csv]
2026-07-06 fix flow bug and map bug
    [partitions.csv]
2026-07-06 fix InnoMaker, add Pcan, add ethernet
    [Begin.ino, Comm.ino, GUI.ino, YieldFlo_ESP32.ino]
2026-07-06 ethernet fix, theme fix, npn sensor addition
    [Begin.ino, Flow.ino, GUI.ino, YieldFlo_ESP32.ino, YieldFlo_STM32F1.ino]
2026-07-06 add canbus help
2026-07-07 canbus error checking
2026-07-07 fix calibrate
2026-07-07 fix button colors
2026-07-07 Derive TestWeightKgPerBu from single source of truth
    TestWeightKgPerBu was a stored copy of Core.Yield.TestWeightLbsBu,
    kept in sync by a single assignment in LoadJobConfig. Their defaults
    already disagreed (25.4 = 56 lb/bu vs 60), so before a crop loaded —
    or if seeding failed — the two diverged and skewed mass display and
    calibration. Make it a computed property derived from TestWeightLbsBu
    so the two can never disagree, and drop the redundant assignment.
2026-07-07 Fix duplicate active jobs; New starts job with a guard
    Creating a job inserted it with status 'Active', so a new job created
    while another was recording left two 'Active' rows in the DB — shown as
    two active jobs and able to resume the wrong one on next start.
    - JobRepo.Create now inserts status 'New'; a job becomes 'Active' only
    when started, which closes the previously active job (single-active
    invariant holds).
    - New now starts the job it creates (applies config, marks Active,
    switches the collector), so a valid new job becomes the active one.
    - Starting a new job while another is active prompts for confirmation
    to prevent accidentally abandoning a job in progress (including wh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
2026-07-08 update can driver
2026-07-12 add pulse filter
2026-07-22 add a map recal button
2026-07-23 add pcbs
    [BOM-Moisture1.csv, BOM-YF1.csv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]
2026-07-24 fix wire bug
2026-07-25 optical sensor
